anantppandey/servoless-leader-arm/assets/servo_1_cut_4.PNG

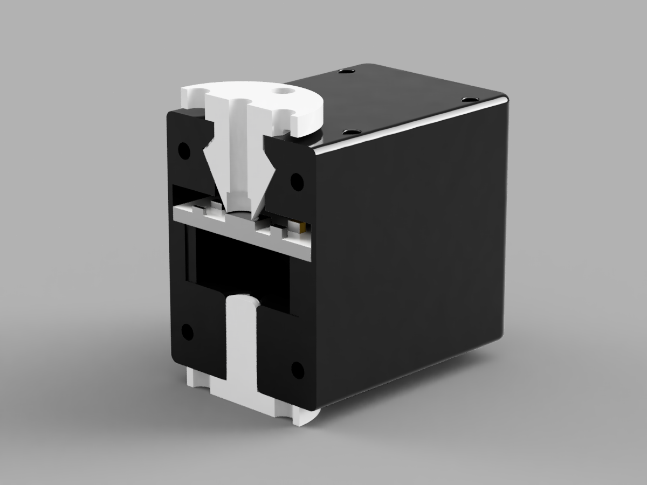
assets/servo_1_cut_4.PNG
