anantppandey/servoless-leader-arm/CAD/PCB/PCB_PCB_OpenBot-Leader-Arm-v0.9_2025-06-12.png

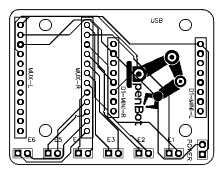
CAD/PCB/PCB_PCB_OpenBot-Leader-Arm-v0.9_2025-06-12.png
