anantppandey/servoless-leader-arm/CAD/PCB/Schematic_OpenBot-Leader-Arm-v0.9_2025-06-12.png

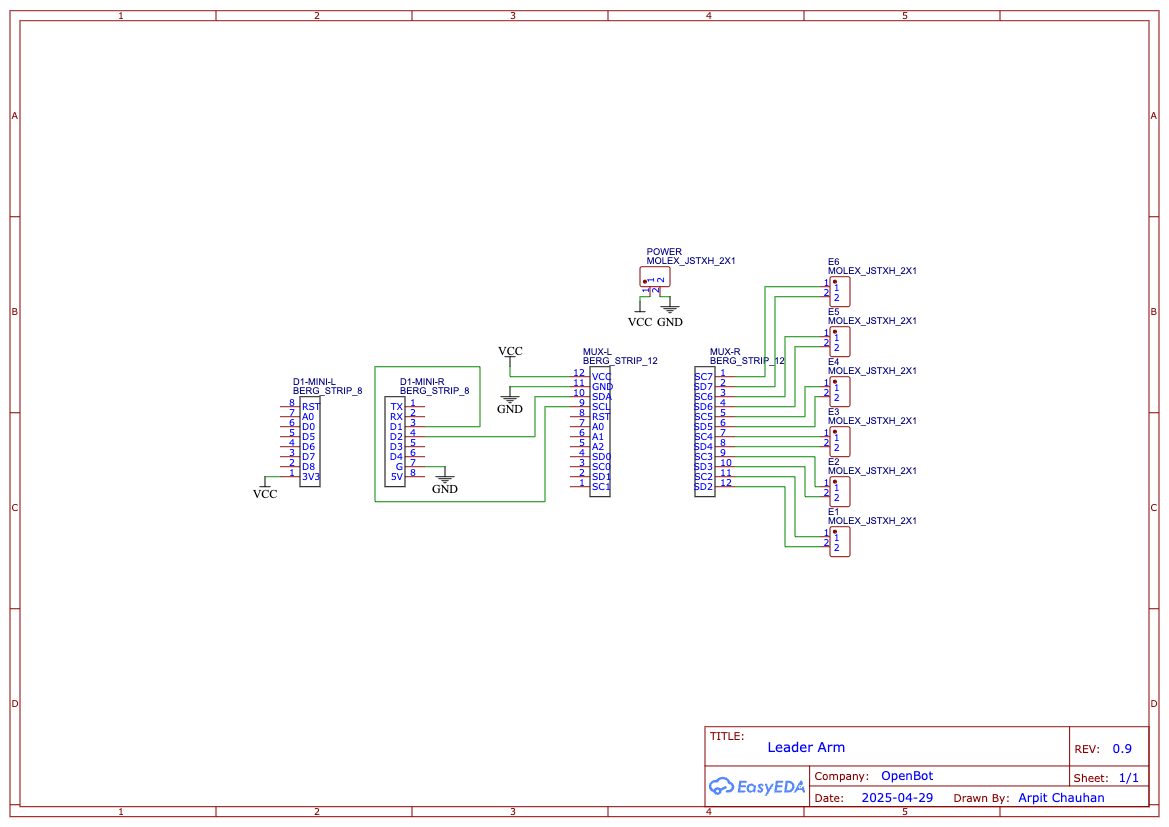
CAD/PCB/Schematic_OpenBot-Leader-Arm-v0.9_2025-06-12.png
