anantppandey/servoless-leader-arm/assets/leader_3d_parts.jpeg

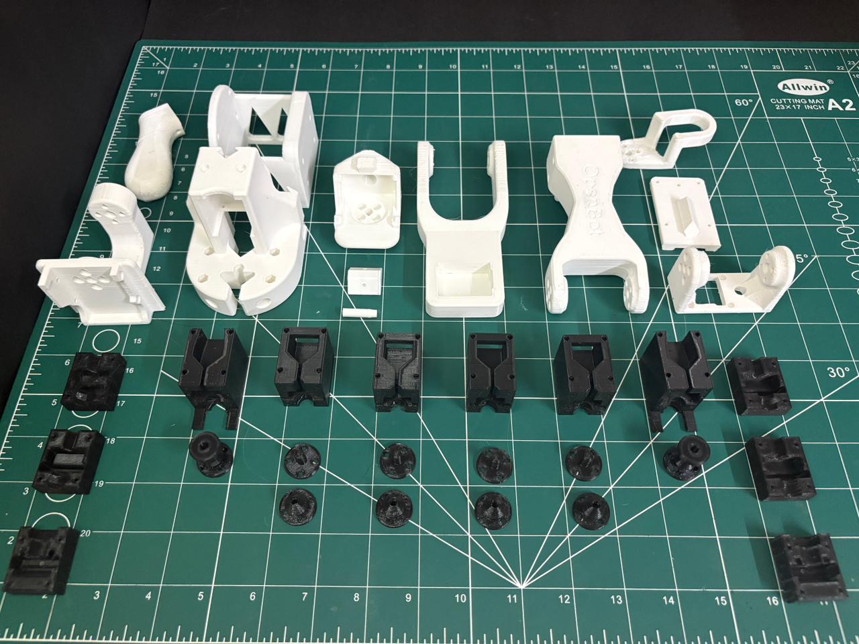
assets/leader_3d_parts.jpeg
