anantppandey/servoless-leader-arm/CAD/STEP/as5600_servo_1.step

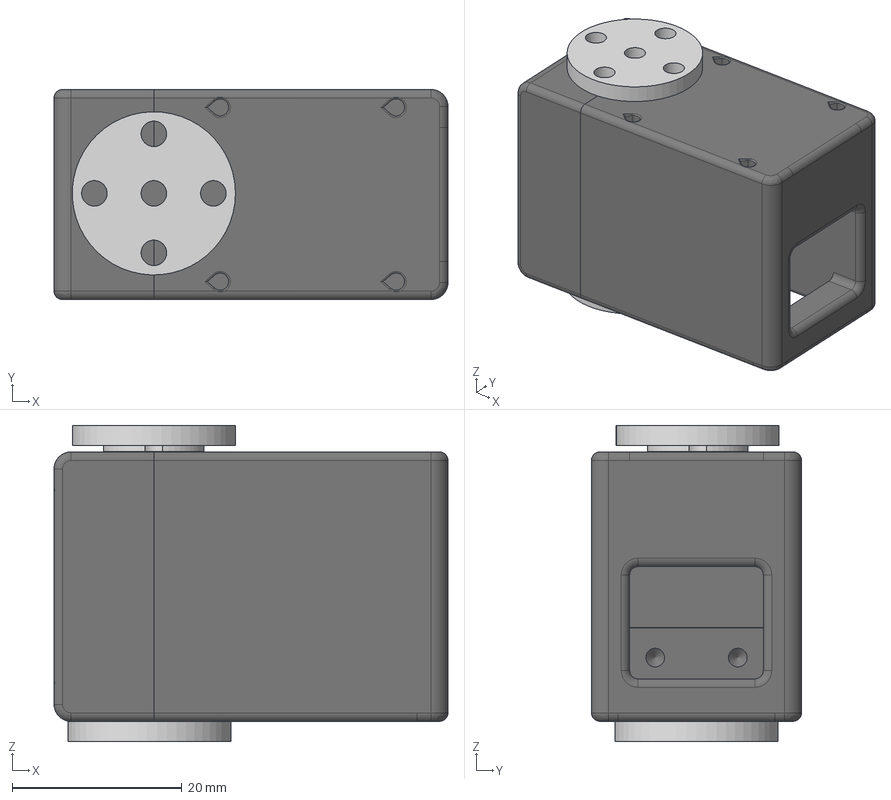
[picture p15: CAD file, 2025-06-24]
CAD/STEP/as5600_servo_1.step
46.4 x 24.7 x 37.2 mm
AS5600_Base
AS5600_Sensor
AS5600_Shaft_Holder v4
AS5600_Shaft v3
AS5600_Cap v2
cable_retainer
