anantppandey/servoless-leader-arm/CAD/STL/servo_driver_mount.stl

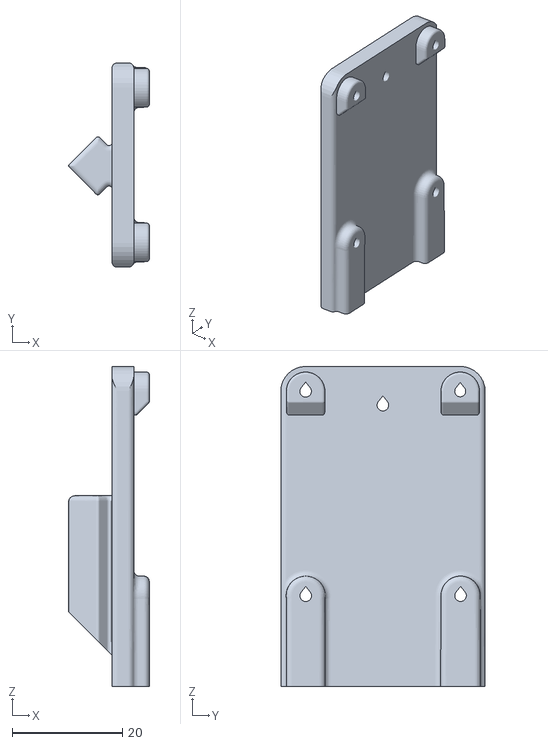
[picture p16: CAD file, 2025-06-24]
CAD/STL/servo_driver_mount.stl
14.6 x 37.0 x 58.0
