anantppandey/servoless-leader-arm/CAD/STEP/as5600_servo_2.step

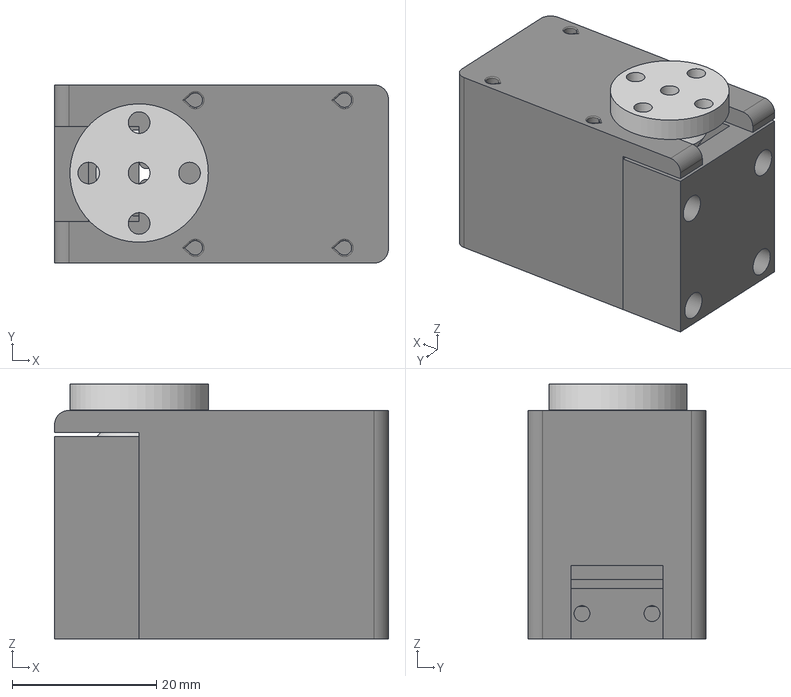
[picture p17: CAD file, 2025-06-24]
CAD/STEP/as5600_servo_2.step
46.4 x 24.7 x 35.3 mm
AS5600_Base
AS5600_Shaft_Holder v4
AS5600_Shaft v3
retainer
