anantppandey/servoless-leader-arm/CAD/STL/shoulder_pan_pin.stl

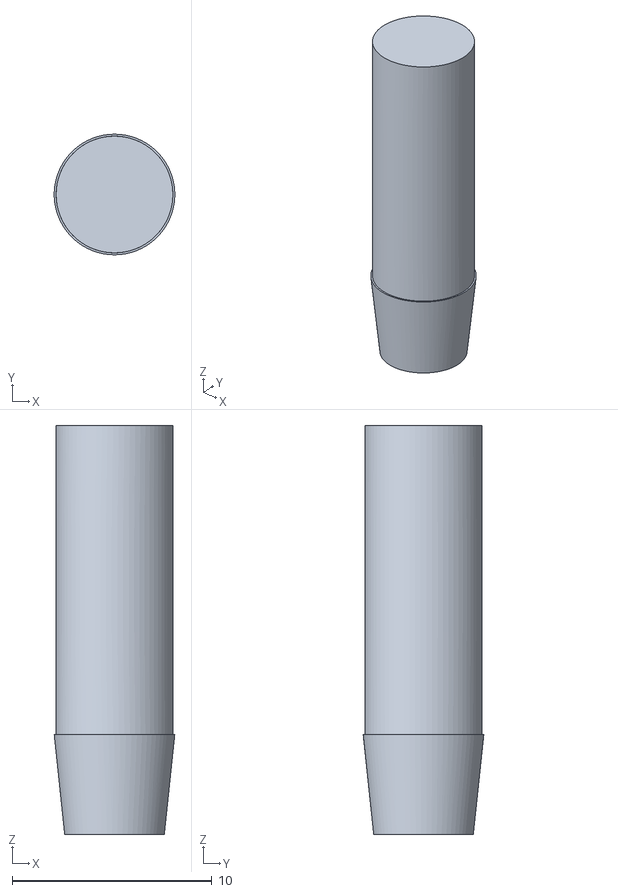
[picture p18: CAD file, 2025-06-24]
CAD/STL/shoulder_pan_pin.stl
6.04 x 6.05 x 20.5
