anantppandey/servoless-leader-arm/CAD/STL/base.stl

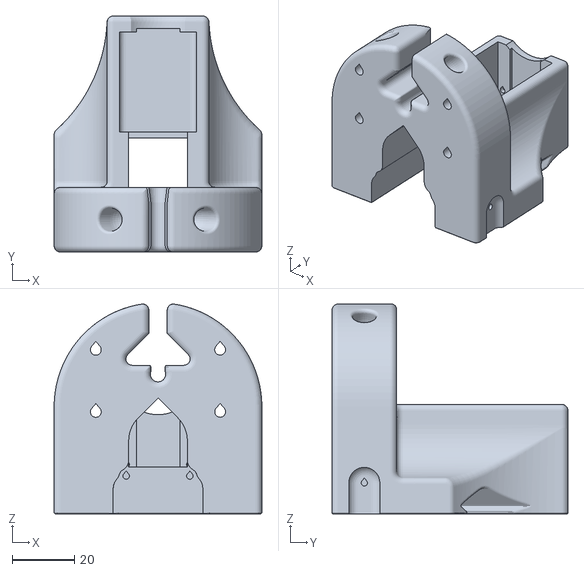
[picture p19: CAD file, 2025-06-24]
CAD/STL/base.stl
66.9 x 76.0 x 67.6
