anantppandey/servoless-leader-arm/CAD/STL/elbow.stl

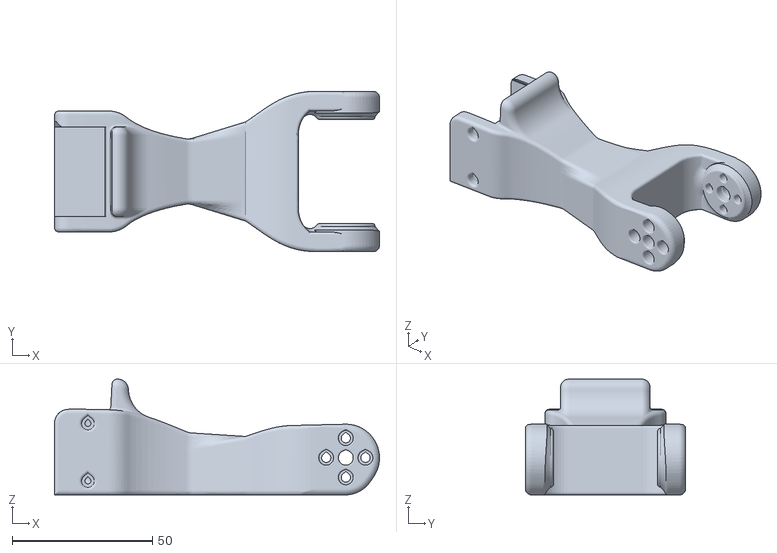
[picture p20: CAD file, 2025-06-24]
CAD/STL/elbow.stl
115.9 x 57.2 x 41.3
