anantppandey/servoless-leader-arm/CAD/STL/wrist_1.stl

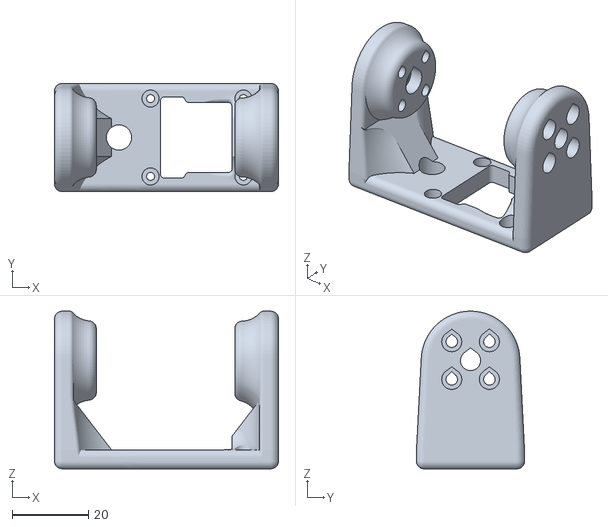
[picture p21: CAD file, 2025-06-24]
CAD/STL/wrist_1.stl
58.9 x 28.4 x 41.5
