anantppandey/servoless-leader-arm/CAD/STL/leader_wrist_2.STL

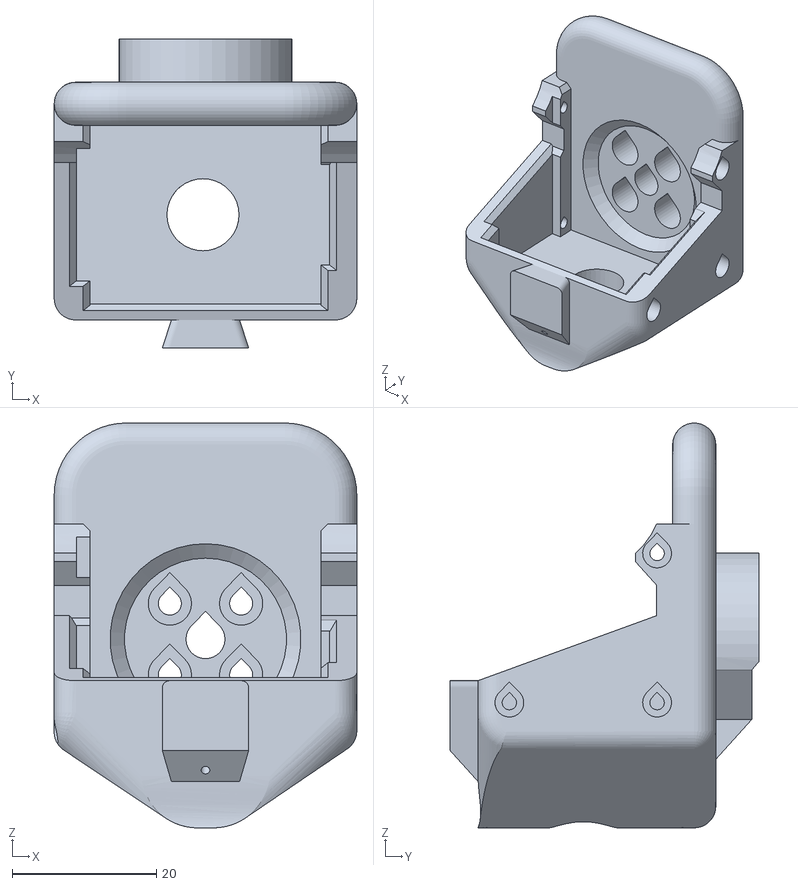
[picture p22: CAD file, 2025-06-24]
CAD/STL/leader_wrist_2.STL
42.0 x 42.9 x 56.2
