anantppandey/servoless-leader-arm/CAD/STL/leader_clamp_base.stl

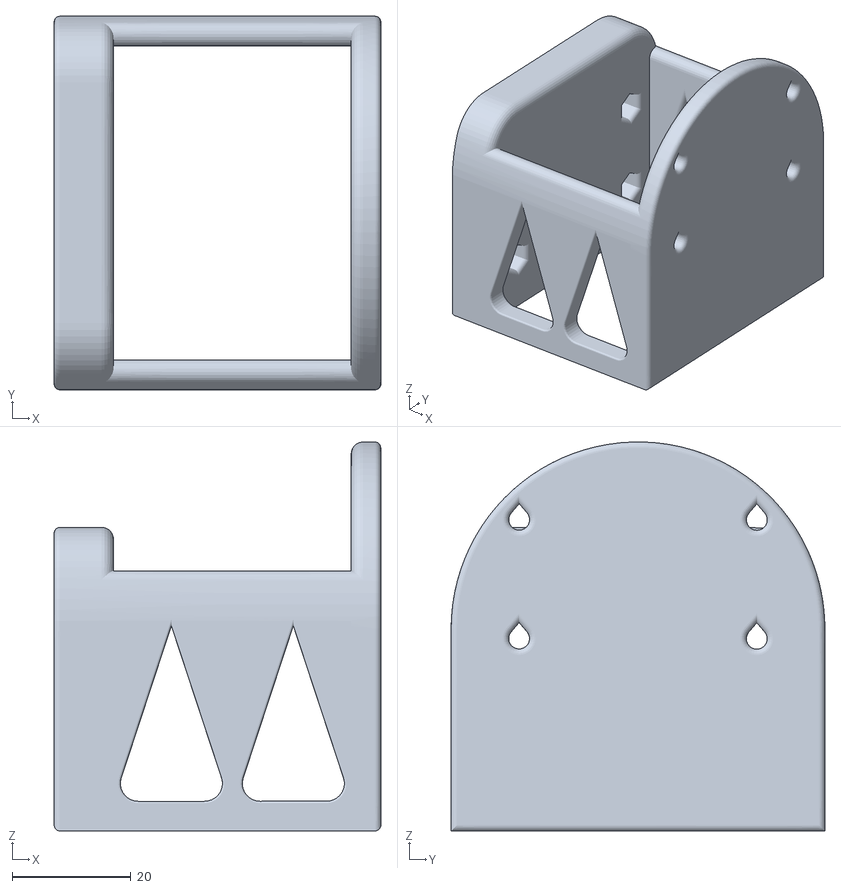
[picture p23: CAD file, 2025-06-24]
CAD/STL/leader_clamp_base.stl
55.0 x 62.9 x 65.5
