anantppandey/servoless-leader-arm/CAD/STL/leader_gripper_finger.STL

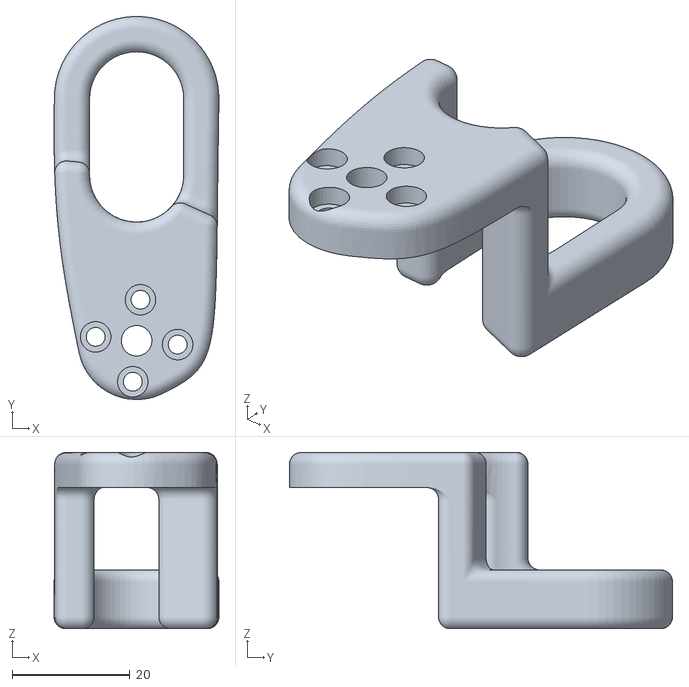
[picture p24: CAD file, 2025-06-24]
CAD/STL/leader_gripper_finger.STL
28.0 x 65.1 x 30.0
