anantppandey/servoless-leader-arm/CAD/STL/leader_handle.STL

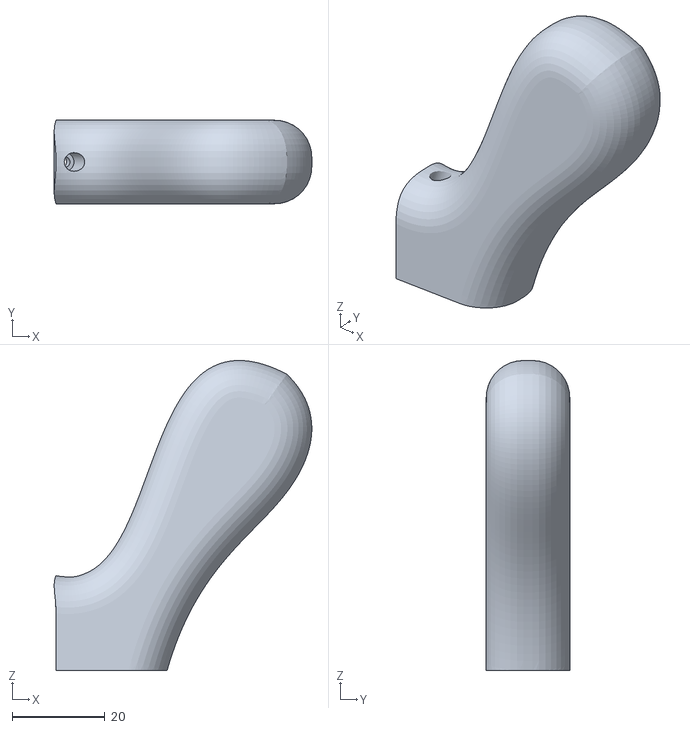
[picture p25: CAD file, 2025-06-24]
CAD/STL/leader_handle.STL
55.5 x 18.0 x 66.7
