anantppandey/servoless-leader-arm/CAD/STL/shoulder_pan.stl

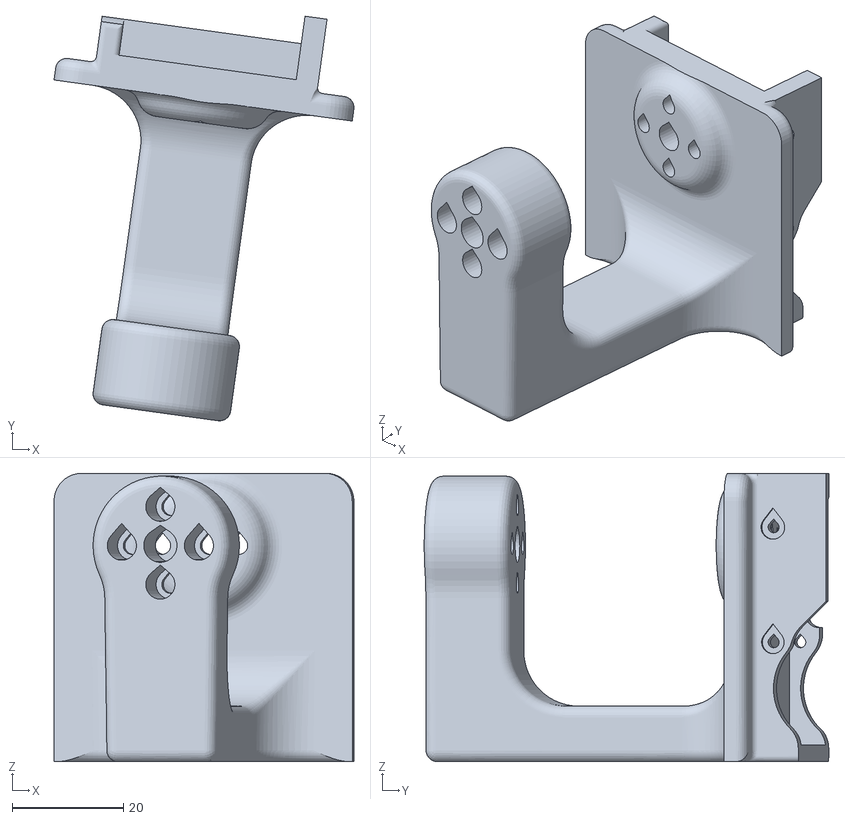
[picture p26: CAD file, 2025-06-24]
CAD/STL/shoulder_pan.stl
54.0 x 72.8 x 51.9
