anantppandey/servoless-leader-arm/CAD/STL/shoulder_pan_retainer.stl

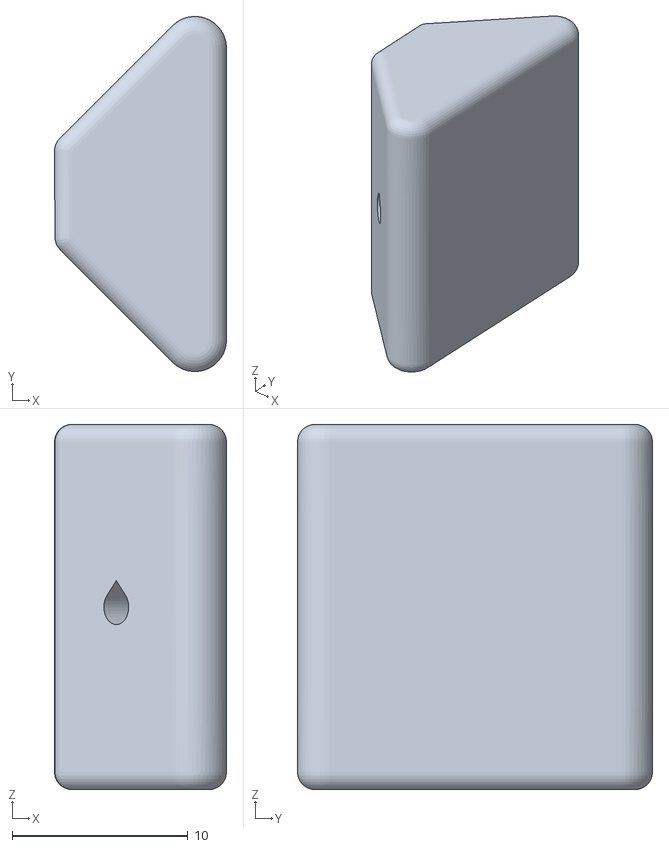
[picture p27: CAD file, 2025-06-24]
CAD/STL/shoulder_pan_retainer.stl
9.80 x 20.2 x 20.8
