anantppandey/servoless-leader-arm/CAD/STL/shoulder_lift.stl

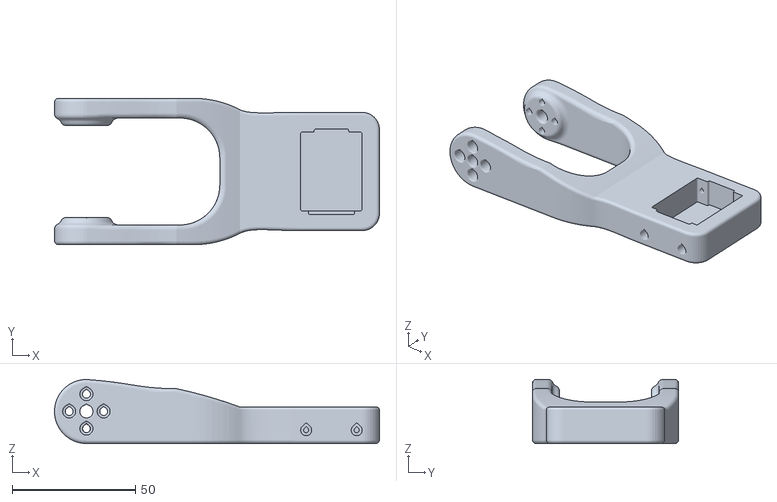
[picture p28: CAD file, 2025-06-24]
CAD/STL/shoulder_lift.stl
131.9 x 59.4 x 26.0
