anantppandey/servoless-leader-arm/(list of files, cad)

Other CAD files:
CAD/STL/as5600_servo_1.stl
CAD/STL/as5600_servo_2.stl
CAD/f360/as5600_servo_1.f3d
CAD/f360/as5600_servo_2.f3d
